danicruz0415/Mural01/README.md

# Mural01
Design files, 3D models, cuts and circuits used for my first mural

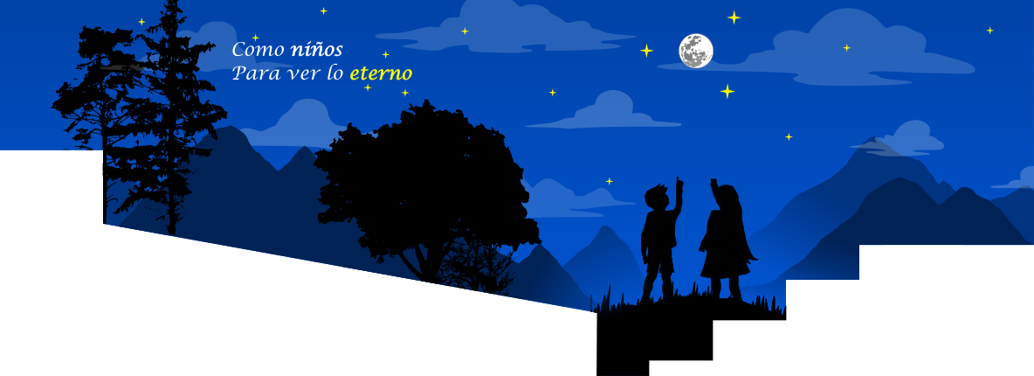
[picture p1: imageDesign/muralDesignRendered.png]
Mural Design
