danicruz0415/Mural01/3DDesigns/Moon.FCStd

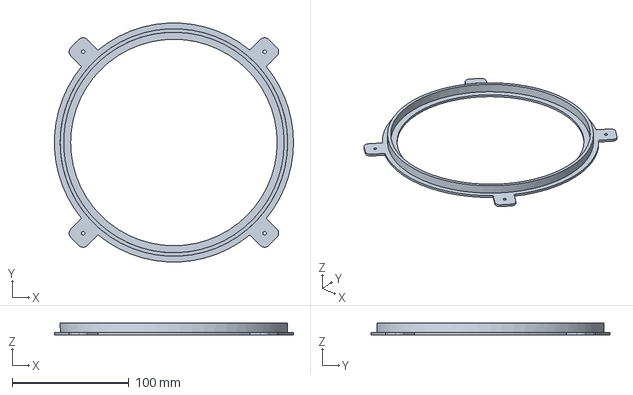
[picture p2: CAD file, 2025-10-09]
3DDesigns/Moon.FCStd
204.9 x 204.7 x 10.0 mm
