danicruz0415/Mural01/3DDesigns/star.FCStd

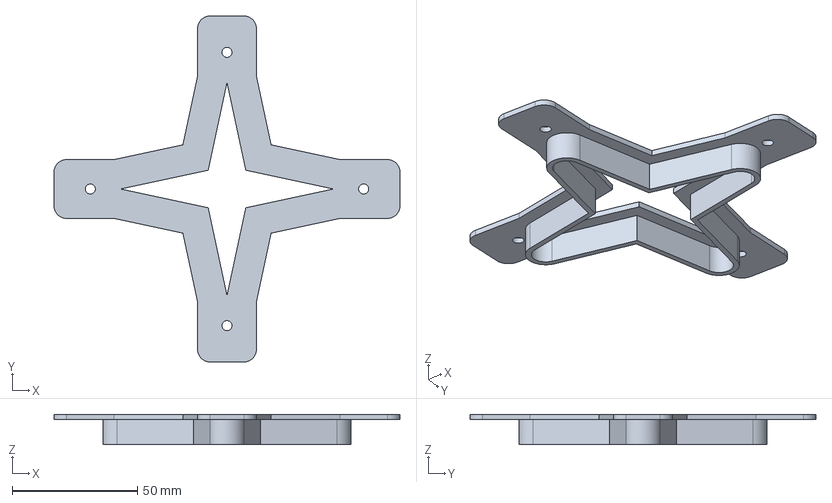
[picture p3: CAD file, 2025-10-09]
3DDesigns/star.FCStd
138.0 x 138.0 x 12.0 mm
