danicruz0415/Mural01/circuitDesigns/mainControllerCircuit/mainControllerCircuit.kicad_pcb

## KiCad design circuitDesigns/mainControllerCircuit/mainControllerCircuit.kicad_pcb (2025-10-19)

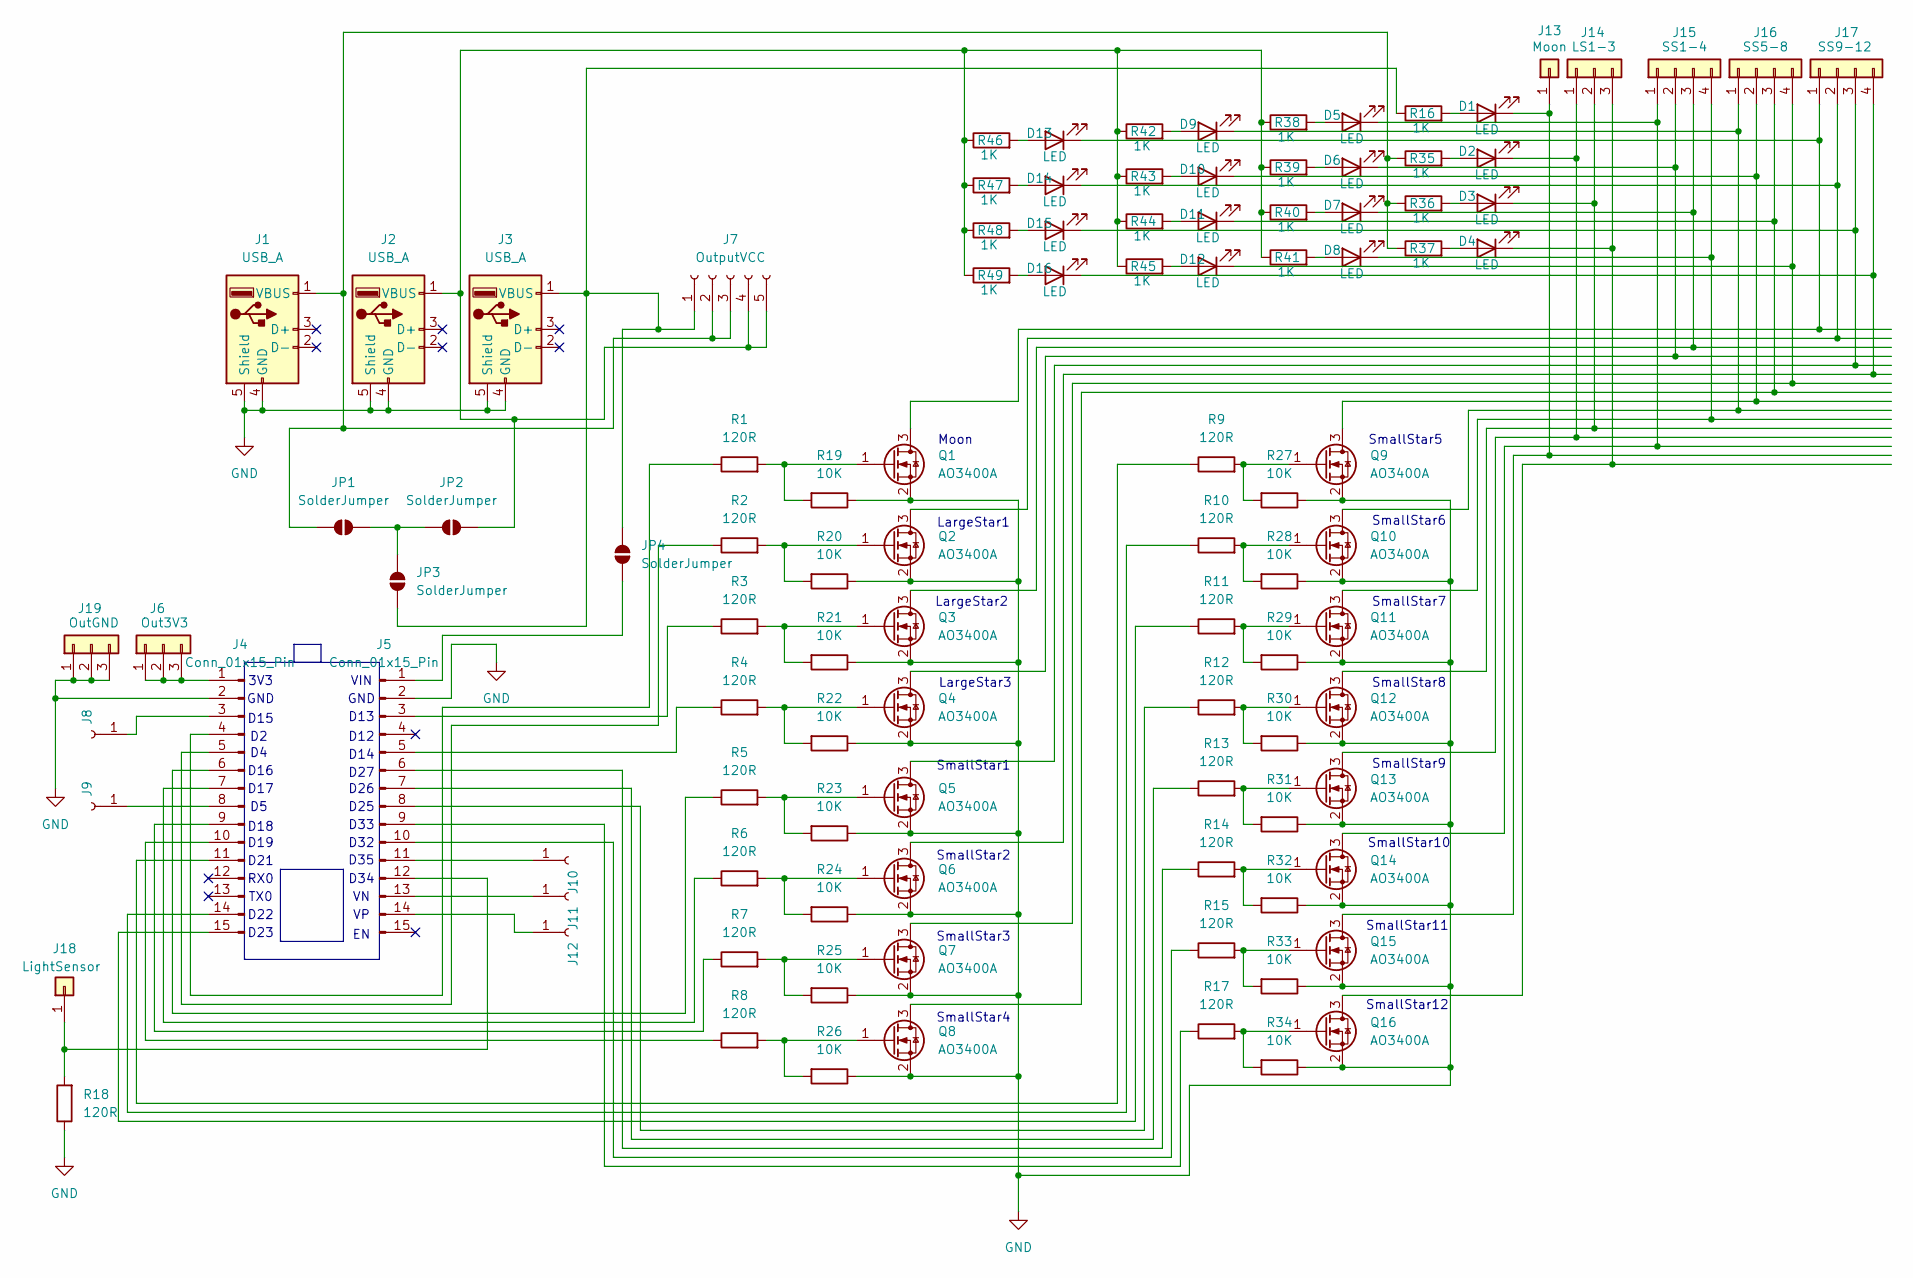
[picture p4: schematic mainControllerCircuit.kicad_sch]

Parts:
D1, D2, D3, D4, D5, D6, D7, D8, D9, D10, D11, D12, D13, D14, D15, D16: LED; LED_D3.0mm
J1, J2, J3: USB_A; USB_A_Molex_67643_Horizontal
J4, J5: Conn_01x15_Pin; PinSocket_1x15_P2.54mm_Vertical
J6: Out3V3; PinSocket_1x03_P2.54mm_Vertical
J7: OutputVCC; PinSocket_1x05_P2.54mm_Vertical
J8, J9, J10, J11, J12: PinSocket_1x01_P2.54mm_Vertical
J13: Moon; PinSocket_1x01_P2.54mm_Vertical
J14: LS1-3; PinSocket_1x03_P2.54mm_Vertical
J15: SS1-4; PinSocket_1x04_P2.54mm_Vertical
J16: SS5-8; PinSocket_1x04_P2.54mm_Vertical
J17: SS9-12; PinSocket_1x04_P2.54mm_Vertical
J18: LightSensor; PinSocket_1x01_P2.54mm_Vertical
J19: OutGND; PinSocket_1x03_P2.54mm_Vertical
JP1, JP2, JP3, JP4: SolderJumper; PinSocket_1x02_P2.54mm_Vertical
Q1, Q2, Q3, Q4, Q5, Q6, Q7, Q8, Q9, Q10, Q11, Q12, Q13, Q14, Q15, Q16: AO3400A; SOT-23
R1, R2, R3, R4, R5, R6, R7, R8, R9, R10, R11, R12, R13, R14, R15, R17, R18: 120R; R_Axial_DIN0207_L6.3mm_D2.5mm_P7.62mm_Horizontal
R16, R35, R36, R37, R38, R39, R40, R41, R42, R43, R44, R45, R46, R47, R48, R49: 1K; R_Axial_DIN0207_L6.3mm_D2.5mm_P7.62mm_Horizontal
R19, R20, R21, R22, R23, R24, R25, R26, R27, R28, R29, R30, R31, R32, R33, R34: 10K; R_Axial_DIN0207_L6.3mm_D2.5mm_P7.62mm_Horizontal

Connections:
GND: J1.4 (GND), J1.5 (Shield), J2.4 (GND), J2.5 (Shield), J3.4 (GND), J3.5 (Shield), J4.2, J5.2, J19.1, J19.2, J19.3, Q1.2 (S), Q2.2 (S), Q3.2 (S), Q4.2 (S), Q5.2 (S), Q6.2 (S), Q7.2 (S), Q8.2 (S), Q9.2 (S), Q10.2 (S), Q11.2 (S), Q12.2 (S), Q13.2 (S), Q14.2 (S), Q15.2 (S), Q16.2 (S), R18.1, R19.1, R20.1, R21.1, R22.1, R23.1, R24.1, R25.1, R26.1, R27.1, R28.1, R29.1, R30.1, R31.1, R32.1, R33.1, R34.1
unnamed: D1.2 (A), R16.2
unnamed: D1.1 (K), J13.1, Q15.3 (D)
unnamed: D2.2 (A), R35.2
unnamed: D2.1 (K), J14.1, Q13.3 (D)
unnamed: D3.2 (A), R36.2
unnamed: D3.1 (K), J14.2, Q12.3 (D)
unnamed: D4.2 (A), R37.2
unnamed: D4.1 (K), J14.3, Q16.3 (D)
unnamed: D5.2 (A), R38.2
unnamed: D5.1 (K), J15.1, Q14.3 (D)
unnamed: D6.2 (A), R39.2
unnamed: D6.1 (K), J15.2, Q4.3 (D)
unnamed: D7.2 (A), R40.2
unnamed: D7.1 (K), J15.3, Q3.3 (D)
unnamed: D8.2 (A), R41.2
unnamed: D8.1 (K), J15.4, Q11.3 (D)
unnamed: D9.2 (A), R42.2
unnamed: D9.1 (K), J16.1, Q10.3 (D)
unnamed: D10.2 (A), R43.2
unnamed: D10.1 (K), J16.2, Q9.3 (D)
unnamed: D11.2 (A), R44.2
unnamed: D11.1 (K), J16.3, Q8.3 (D)
unnamed: D12.2 (A), R45.2
unnamed: D12.1 (K), J16.4, Q7.3 (D)
unnamed: D13.2 (A), R46.2
unnamed: D13.1 (K), J17.1, Q1.3 (D)
unnamed: D14.2 (A), R47.2
unnamed: D14.1 (K), J17.2, Q2.3 (D)
unnamed: D15.2 (A), R48.2
unnamed: D15.1 (K), J17.3, Q5.3 (D)
unnamed: D16.2 (A), R49.2
unnamed: D16.1 (K), J17.4, Q6.3 (D)
unnamed: J1.1 (VBUS), J7.2, J7.3, JP1.2 (B), R35.1, R36.1, R37.1
unnamed: J2.1 (VBUS), J7.4, J7.5, JP2.2 (B), R38.1, R39.1, R40.1, R41.1, R42.1, R43.1, R44.1, R45.1, R46.1, R47.1, R48.1, R49.1
unnamed: J3.1 (VBUS), J7.1, JP3.1 (A), JP4.2 (B), R16.1
unnamed: J4.1, J6.1, J6.2, J6.3
unnamed: J4.3, J8.1
unnamed: J4.4, R1.1
unnamed: J4.5, R2.1
unnamed: J4.6, R5.1
unnamed: J4.7, R6.1
unnamed: J4.8, J9.1
unnamed: J4.9, R7.1
unnamed: J4.10, R8.1
unnamed: J4.11, R9.1
unnamed: J4.14, R10.1
unnamed: J4.15, R11.1
unnamed: J5.1, JP4.1 (A)
unnamed: J5.3, R3.1
unnamed: J5.5, R4.1
unnamed: J5.6, R14.1
unnamed: J5.7, R13.1
unnamed: J5.8, R12.1
unnamed: J5.9, R17.1
unnamed: J5.10, R15.1
unnamed: J5.11, J10.1
unnamed: J5.13, J11.1
unnamed: J5.14, J12.1
unnamed: J5.12, J18.1, R18.2
unnamed: JP1.1 (A), JP2.1 (A), JP3.2 (B)
unnamed: Q1.1 (G), R1.2, R19.2
unnamed: Q2.1 (G), R2.2, R20.2
unnamed: Q3.1 (G), R3.2, R21.2
unnamed: Q4.1 (G), R4.2, R22.2
unnamed: Q5.1 (G), R5.2, R23.2
unnamed: Q6.1 (G), R6.2, R24.2
unnamed: Q7.1 (G), R7.2, R25.2
unnamed: Q8.1 (G), R8.2, R26.2
unnamed: Q9.1 (G), R9.2, R27.2
unnamed: Q10.1 (G), R10.2, R28.2
unnamed: Q11.1 (G), R11.2, R29.2
unnamed: Q12.1 (G), R12.2, R30.2
unnamed: Q13.1 (G), R13.2, R31.2
unnamed: Q14.1 (G), R14.2, R32.2
unnamed: Q15.1 (G), R15.2, R33.2
unnamed: Q16.1 (G), R17.2, R34.2

Notes on the sheet:
D26
GND
SmallStar11
TX0
SmallStar4
3V3
D14
D33
D15
D35
D16
VIN
LargeStar3
D17
Moon
D22
LargeStar1
SmallStar10
D19
D27
D12
SmallStar6
D23
SmallStar5
SmallStar7
RX0
SmallStar3
LargeStar2
D25
D18
D21
SmallStar9
D32
SmallStar2
D34
SmallStar1
SmallStar12
SmallStar8
D13

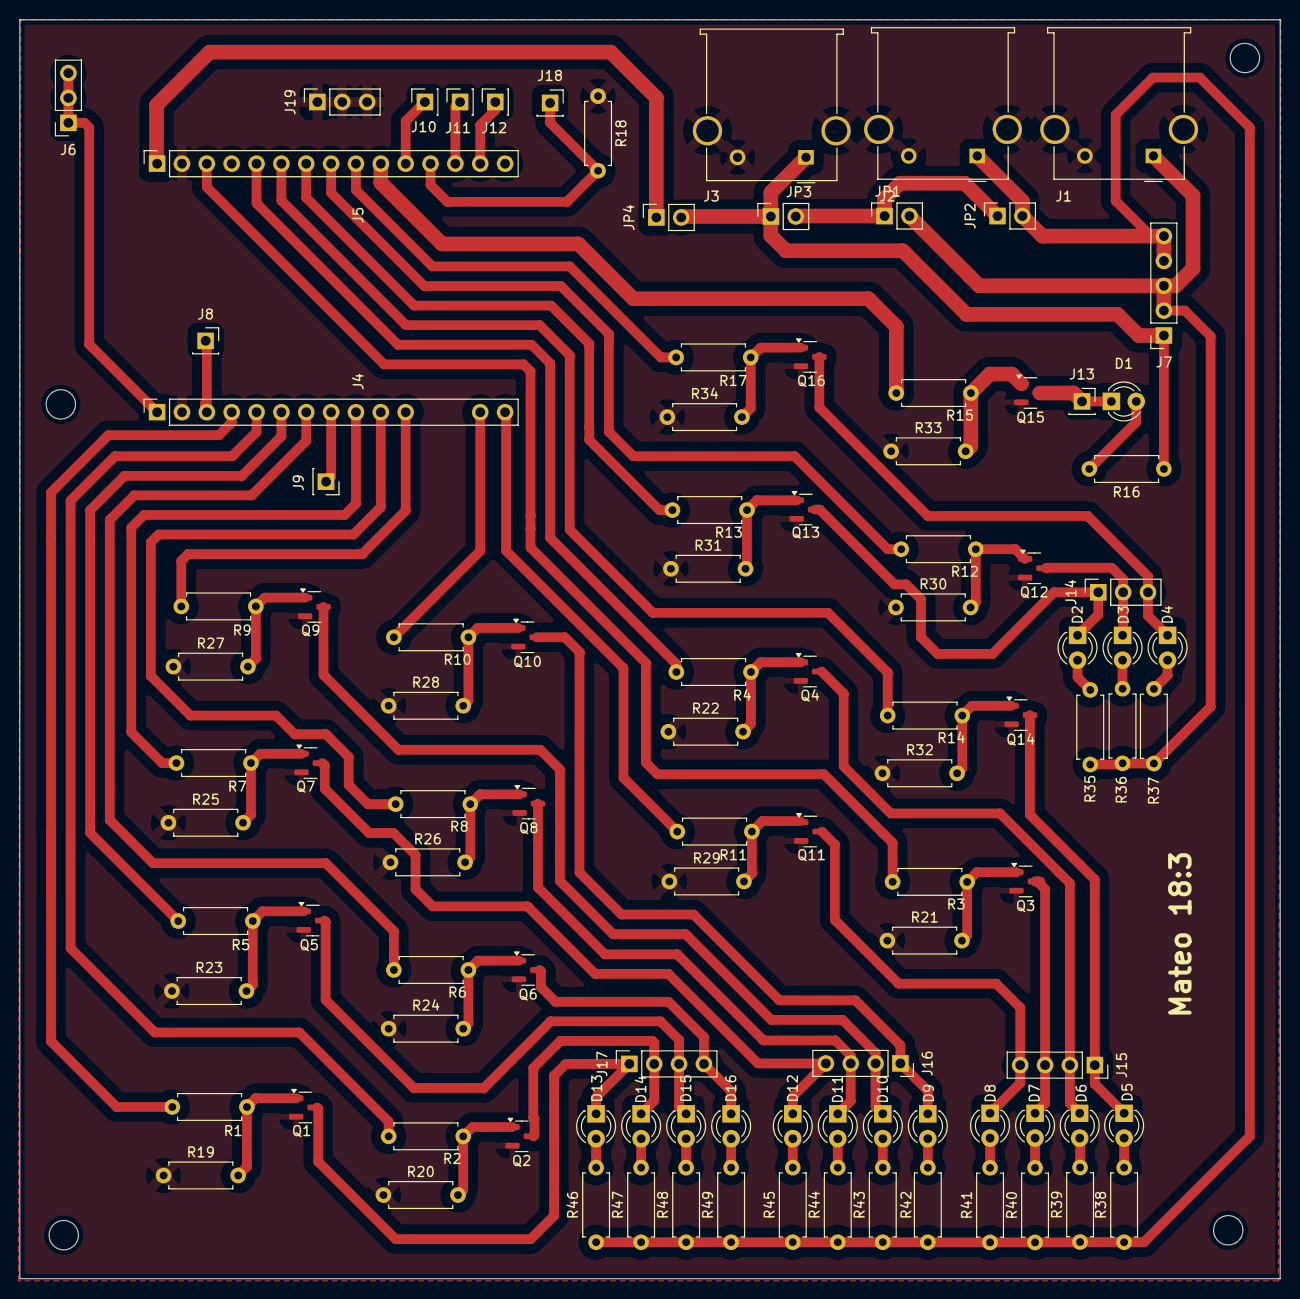
[picture p5: board mainControllerCircuit.kicad_pcb from above]

Board: 2 copper layers, 128.8 x 128.6 mm, 104 parts (0 on the bottom side), 77 nets.
