danicruz0415/Mural01/circuitDesigns/smallStarCircuit/smallStarCircuit.kicad_pcb

## KiCad design circuitDesigns/smallStarCircuit/smallStarCircuit.kicad_pcb (2025-10-15)

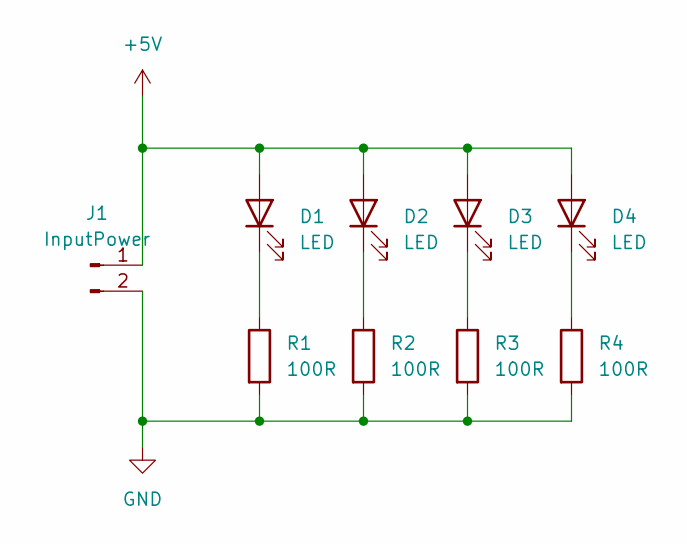
[picture p6: schematic smallStarCircuit.kicad_sch]

Parts:
D1, D2, D3, D4: LED; Custom5050LED
J1: InputPower; CustomIOConnector
R1, R2, R3, R4: 100R; R_1206_3216Metric_Pad1.30x1.75mm_HandSolder

Connections:
+5V: D1.2 (A), D2.2 (A), D3.2 (A), D4.2 (A), J1.1
GND: J1.2, R1.2, R2.2, R3.2, R4.2
unnamed: D1.1 (K), R1.1
unnamed: D2.1 (K), R2.1
unnamed: D3.1 (K), R3.1
unnamed: D4.1 (K), R4.1

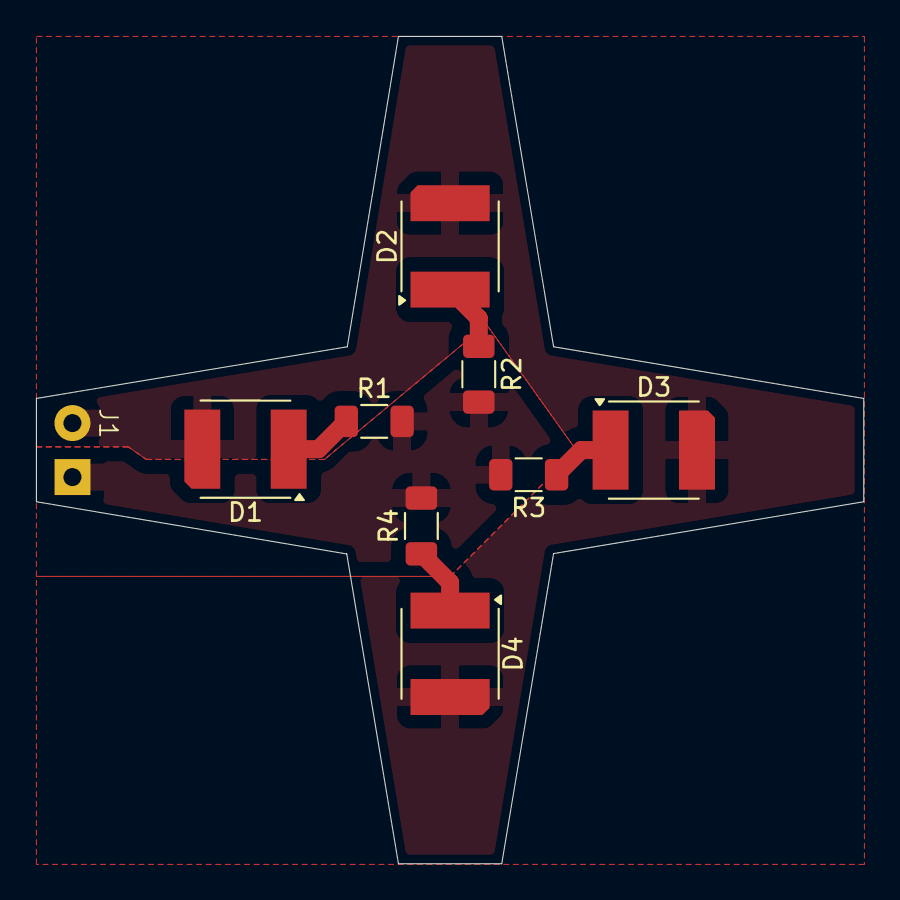
[picture p7: board smallStarCircuit.kicad_pcb from above]

Board: 2 copper layers, 46.0 x 46.0 mm, 9 parts (0 on the bottom side), 6 nets.
