danicruz0415/Mural01/(commit log)

2025-10-09 Adds design files for cuts, circuits and 3D printable parts
    [Moon.FCStd, mainControllerCircuit.kicad_pcb, mainControllerCircuit.kicad_sch, smallStarCircuit.kicad_pcb, smallStarCircuit.kicad_sch, star.FCStd]
2025-10-11 Updates design files for main controller to better accomodate to manufacturer specs
    [mainControllerCircuit.kicad_pcb, mainControllerCircuit.kicad_sch]
2025-10-12 Increases clearances between the pads to not have a safer margin above the minimum limits of the manufacturer
    [mainControllerCircuit.kicad_pcb, mainControllerCircuit.kicad_sch]
2025-10-14 Improves circuit design adding better clearances and using thermal relieves on power planes
    [mainControllerCircuit.kicad_pcb, smallStarCircuit.kicad_pcb]
2025-10-14 Adds corner to custom's 5050LED footprint, to distiguish polarity and to give extra room for the power to pass right next to the LED on the edges
2025-10-15 Adds local gitignore to not track kicad backups
2025-10-15 Improves circuit design by adding thermal relieves and improving the position of ground and power planes
    [smallStarCircuit.kicad_pcb]
2025-10-19 Fixes error in controller circuit: mosfets were missing pull down resistor
    [mainControllerCircuit.kicad_pcb, mainControllerCircuit.kicad_sch]
2025-10-19 Adds LED indicators to the main controller board
    [mainControllerCircuit.kicad_pcb, mainControllerCircuit.kicad_sch]
2025-10-19 Adds mounting holes to the main controller's PCB
    [mainControllerCircuit.kicad_pcb]
2025-10-19 Increases the thickness for the trace of the moon controller as its the one that will handle the most current. Fixes missing ground connection
    [mainControllerCircuit.kicad_pcb]
2025-10-19 Removes reference rects
    [mainControllerCircuit.kicad_pcb]
2025-10-19 Adds quote to the main controller board
    [mainControllerCircuit.kicad_pcb]
2025-10-28 Updates design to match current wall dimentions. Relocates star positions. Adds star to complete 12 stars
2025-10-28 Updates pins for stars to match the last circuit design. Updates analog write res and framerate.
2025-10-28 Adds design for external wiring
2025-10-30 Adds power lines to external wiring diagram
2025-11-04 Reallocates cut files. Add cuts for mirrors and wire paths for large star design and moon design
2025-11-04 Adds color squema to external wiring
2025-11-10 Adds cut that represents the moon's silhouette
